BGorenc/WiFi_Controlled_Lightsaber/(threads)

Thread 13 (2024-07-05):

Clear URL Get Request

BGorenc, 2024-07-05:
Currently after pressing a button the browser URL retains the GET request. It would be ideal to clear this only leaving the base URL. **Due to the limitations of running a web server on an Arduino, many standard solutions are not viable.**

This issue is to explore possible solutions that will function on the Arduino.

BGorenc, 2024-07-08:
- [ ] Ensure README doesn't need updated
- [ ] Replace Webpage Title with `String webpageTitle = "Lightsaber Control";`
- [ ] Replace IP address with `#define setArduinoIP IPAddress(xxx, xxx, x, xxx)`

Closed 2024-07-08.
