BGorenc/WiFi_Controlled_Lightsaber/arduino_controller/arduino_controller.ino

/*
* The objective of this project is to employ an Arduino microcontroller 
* that can wirelessly control WS2812B LED strips over Wi-Fi, this 
* functionality is combined with a physical lightsaber hilt to provide 
* an aesthetically pleasing decoration for any room.
* Copyright (C) 2023  Benjamin Gorenc
*
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
* You should have received a copy of the GNU General Public License
* along with this program.  
* If not, see https://www.gnu.org/licenses/gpl-3.0.html.
*/


#include <SPI.h>
#include <WiFiNINA.h>
#include <FastLED.h>
#include "webserver_config.h"

/* **********************SETTINGS********************** */
/* Settings for Arduino */
#define DATA_PIN 2                               // First LED Pin
#define DATA_PIN_CLONE 3                         // Second LED Pin
unsigned long randomModeDurationMinutes = 10;    // Set the duration in minutes

/* Settings for LED Strip */
#define NUM_LEDS 144                             // Number of LEDS per Strip
#define CHIP_SET WS2812B                         // LED Chip
#define COLOR_ORDER GRB                          // Color Settings for LED Chip
#define BRIGHTNESS 200                           // LED Brightness
#define MAX_VOLTS 5
#define MAX_AMPS 4500
#define BAUD 57600
/* **********************SETTINGS********************** */

char ssid[] = SECRET_SSID;
char pass[] = SECRET_PASSWORD;
int keyIndex = 0;
CRGB leds[NUM_LEDS];         // First LED Strip
CRGB ledsClone[NUM_LEDS];    // Second LED Strip
WiFiServer server(80);
String readString;
String webpageTitle = WEBPAGE_TITLE;
bool randomMode = false;
unsigned long randomModeStartTime = 0;
unsigned long randomModeDuration = randomModeDurationMinutes * 60 * 1000; // limit to trigger in milliseconds

void setup(){

  LEDconfig();
  Serial.begin(BAUD);
  WiFi.config(SET_ARDUINO_IP);
  connectToWiFi();
  server.begin();
  randomSeed(analogRead(A0)); // seed the random function using a floating analog value
  startRandomMode();

}

void loop(){

  checkWiFi();
  checkRandomMode();
  runWebServer();

}

void LEDconfig(){

  FastLED.addLeds<CHIP_SET, DATA_PIN, COLOR_ORDER> (leds,NUM_LEDS);
  FastLED.addLeds<CHIP_SET, DATA_PIN_CLONE, COLOR_ORDER> (ledsClone,NUM_LEDS); // Second LED Strip
  FastLED.setBrightness(BRIGHTNESS);
  FastLED.setMaxPowerInVoltsAndMilliamps(MAX_VOLTS, MAX_AMPS);

}

void checkWiFi(){

  if (WiFi.status() != WL_CONNECTED){
    Serial.println("Wi-Fi connection lost. Reconnecting...");
    WiFi.disconnect();
    connectToWiFi(); // Reconnect to Wi-Fi if connection is lost
    Serial.println("Wi-Fi reconnected.");
  }

}

void connectToWiFi(){

  int status = WL_IDLE_STATUS;
  while (status != WL_CONNECTED){
    Serial.print("Attempting to connect to Network named: ");
    Serial.println(ssid);
    status = WiFi.begin(ssid, pass);
    delay(10000);
  }

  Serial.print("SSID: ");
  Serial.println(WiFi.SSID());
  IPAddress ip = WiFi.localIP();
  Serial.print("IP Address: ");
  Serial.println(ip);

}

void manualDisconnect(){

  // function exists for debugging disconnects
  WiFi.disconnect(); // Disconnect from Wi-Fi
  Serial.println("Manually disconnected from Wi-Fi.");

}

void checkRandomMode(){

  if (randomMode){
    unsigned long currentTime = millis();
    if (currentTime - randomModeStartTime >= randomModeDuration){
      Serial.println("Random Mode timer triggered");
      randomModeStartTime = currentTime;
      setRandomHue();
    }
  }

}

void runWebServer(){
  
  // serve client requests
  WiFiClient client = server.available();
  if (client){
    Serial.println();
    Serial.println("new client");

    while (client.connected()){
      if (client.available()){
        char clientData = client.read();
        if (readString.length() < 100){
          readString += clientData;
          Serial.write(clientData);

          if (clientData == '\n'){

            displayWebPage(client);
            parseClientData(readString);

            client.stop();
            Serial.println("client disconnected");
          }
        }
      }
    }
  }

}

void setRandomHue(){

  uint8_t hue = random(256);
  Serial.print("Random Hue: ");
  Serial.println(hue);
  setHueLED(hue);
  delay(1);

}

void turnOffAll(){

  for(int i = (NUM_LEDS - 1); i >= 0; i--){
    leds[i] = CRGB::Black; // turn off the i'th LED
    ledsClone[i] = CRGB::Black; // Second LED Strip
    FastLED.show();
  }
  delay(1);

}

void setHueLED(uint8_t hue){
  
  turnOffAll();
  for(int i = 0; i < NUM_LEDS; i++){
    leds[i].setHue(hue);
    ledsClone[i].setHue(hue); // Second LED Strip
    FastLED.show();
  }
  delay(1);

}

void startRandomMode(){

  Serial.println("Random Mode active");
  randomMode = true;
  randomModeStartTime = millis();
  setRandomHue();
  delay(1);

}

void displayWebPage(WiFiClient& client){

  client.println(R"rawliteral(
  <!DOCTYPE html>
  <html lang='en'>
  <head>
    <meta charset='UTF-8'>
    <meta name='viewport' content='width=device-width, initial-scale=1.0'>
    <link rel='icon' href='data:;base64,iVBORw0KGgo='>
    <title>)rawliteral" + webpageTitle + R"rawliteral(</title>
    <style>
      body { background-color: #E7E9EB; font-family: Arial, sans-serif; }
      h1 { color: #333333; text-align: center; }
      form { text-align: center; }
      .color-slider {
        width: 80%;
        margin: auto;
        background: linear-gradient(to right, red, orange, yellow, green, aqua, blue, purple, pink, red);
        border-radius: 10px;
        padding: 10px 0 20px;
        accent-color: gray;
      }
      input[type='range'] { width: 100%; margin: 5px 0; }
      input[type='number'] { width: 60px; margin-left: 10px; font-size: 18px; }
      input[type='submit'], input[type='button'] {
        padding: 10px 20px;
        font-size: 18px;
        color: white;
        border: none;
        cursor: pointer;
      }
      input[type='submit'] { background-color: gray; }
      input[type='button'] { background-color: red; }
      p.one { border: 2px solid black; padding: 20px; width: 80%; margin: auto; text-align: center; }
      p.instruction { padding: 20px; width: 80%; margin: auto; text-align: center; }
    </style>
  </head>
  <body>
    <h1>)rawliteral" + webpageTitle + R"rawliteral(</h1>
    <br><br>
    <form method='get' action='' onsubmit='return false;'>
      <div class='color-slider'>
        <input type='range' name='ledState' min='0' max='255' value='128' onchange='updateSliderValue(this.value)'>
        <input type='number' name='ledState' id='ledStateNumber' min='0' max='255' value='128' oninput='updateSliderValue(this.value)'>
        <br><br>
        <input type='submit' value='Select Color' onclick='staticColor()'>
      </div>
      <p class='instruction'>
      <br><br>
      To select a fixed color, adjust the slider to the desired hue displayed in the slider's background, then click 'Select Color'. Alternatively, you can enter a value between 0 and 255 to precisely match the color shown in the slider.
      <br><br>
      </p>
      <p class='one'>
        <input type='submit' value='Random Mode' onclick='randomMode()'>
        <br><br>
        <b>Random Mode</b> will automatically select a random color every <b>)rawliteral" + String(randomModeDurationMinutes) + R"rawliteral( minutes</b>. This mode is the default setting when powering on the lightsaber.
        <br>
        <i>Please note that this option will overwrite any other color selections.</i>
      </p>
      <br><br>
      <input type='button' value='Turn Off' onclick='turnOffLED()'>
    </form>
    
    <script>
      function updateSliderValue(value) {
        document.getElementById('ledStateNumber').value = value;
        document.querySelector('[name="ledState"]').value = value;
      }
      function randomMode() {
        window.location.href = '/?ledState=Random';
      }
      function turnOffLED() {
        window.location.href = '/?ledState=TurnOff';
      }
      function staticColor() {
        window.location.href = '/?ledState=' + document.querySelector('[name="ledState"]').value;
      }
      window.onload = function() {
        if(window.location.search) {
          history.replaceState(null, '', '/');
        }
      }
    </script>
  </body>
  </html>
  )rawliteral");
  delay(1);
  
}

void parseClientData(const String& request){

  // Check to make sure the ledStateIndex exists
  int ledStateIndex = request.indexOf("ledState=");
  if (ledStateIndex >= 0){
    // Find the final index of the request to trim excess
    int ledStateEndIndex = request.indexOf(" ", ledStateIndex);
    if (ledStateEndIndex == -1){
      ledStateEndIndex = request.length(); // Use whole string when no match
    }
    // Get the ledState= value
    String ledState = request.substring(ledStateIndex + 9, ledStateEndIndex);
    Serial.println("ledState: " + ledState);
    // Parse Request
    if (ledState == "Random"){
      Serial.println("Random selection made");
      startRandomMode();
    } else if (ledState == "TurnOff") {
      Serial.println("Turn Off Lightsaber");
      randomMode = false;
      turnOffAll();
    } else{
      Serial.println("Static color selection made");
      randomMode = false;
      uint8_t hueValue = ledState.toInt();
      setHueLED(hueValue);
    }
  } else{
    Serial.println("No Selection Found");
  }
  readString = ""; // Clear the readString variable
  delay(1);

}
