BGorenc/WiFi_Controlled_Lightsaber/(commit log)

2023-05-09 stop tracking changes for arduino_secrets.h
2023-05-09 adding fail safe in .gitignore to ensure arduino_secrets.h is not tracked in git
2023-05-09 easy version that uses simple webpage to turn LED on and off
2023-05-10 adding a clear #define to set the arduino's IP address
2023-05-10 changed the web interface to use a drop down selection and a submit button
2023-05-12 adding image folder with circuit layout
2023-05-15 adding minor updates to circuit drawing and name changes in code
2023-05-21 update sketch to match changes and use a second pin to control the second strip
2023-05-29 correcting number of resistors needed
2023-05-29 adding an circuit explanation
2023-05-29 adding a sentence about putting the capacitor on the board
2023-06-11 capcitor voltage update
2023-07-08 Update arduino_secrets.h to have LICENSE tag
2023-07-08 comment errors for settings
    [arduino_controller.ino]
2023-07-09 updating readme in Circuit section
2023-07-22 fixing tab line that should have been spaces
    [arduino_controller.ino]
2023-08-15 Dev (#7)
    * correcting a spelling error in README
    * adding a version of the code that uses a map to store color values
    * added some debug serial prints and a more robust way to process and trim requests
    * added a global title for webpage and the drop down options on webpage are now pulled from the map
    [arduino_controller.ino]
2023-08-16 Random mode (#8)
    * working code for testing
    * changed the timer for random to 10 minutes
    * made changes to README to match the addition of the Random mode
2023-08-26 Wifi drop (#9)
    * adding a fix for dropped wifi
    * cleaned up wifi code and updated firmware
    [arduino_controller.ino]
2024-02-19 Add slider (#12)
    * clean up code and set Random Mode on by default (#11)
    * prototype with rainbow selector
    * adding some more features in html
    * added new buttons for action selection and finilized the static color slider
    * finilized webpage and static color selection logic
    * updated the color gradient for the slider
    * adjusting the slider color gradient to be more accurate
    * updating web interface example
    * removing a comment line
    * update README to match new web interface
    * minor README update
    * added a TODO
    * README updates and wipe IP settings for Arduino
    * minor README update
